wFairmanOlin/kicad_parts/README.md

Just a collection of parts and footprints I've used in projects. There is no guarantee that any of these files are accurate.
