wFairmanOlin/kicad_parts/3D_parts/BK-18650-PC2.step

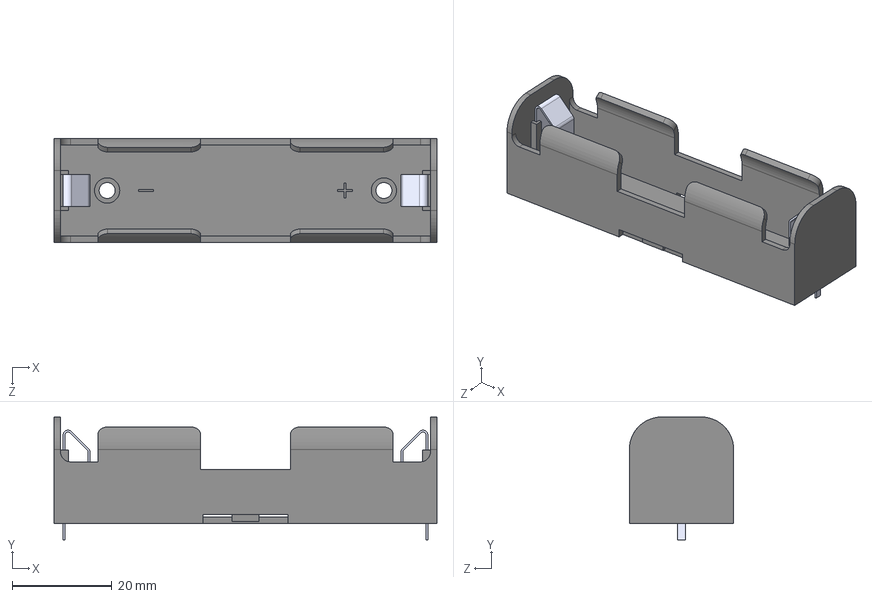
[picture p1: CAD file, 2022-10-13]
3D_parts/BK-18650-PC2.step
77.0 x 24.7 x 21.0 mm
