wFairmanOlin/kicad_parts/3D_parts/DRL0008A.stp

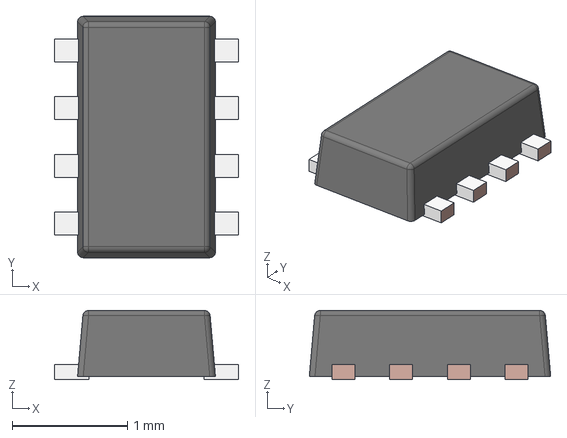
[picture p2: CAD file, 2022-10-13]
3D_parts/DRL0008A.stp
1.60 x 2.10 x 0.6 mm
FRAME-DRL0008A
BODY-SOT
