wFairmanOlin/kicad_parts/3D_parts/Female Pin Header 01x05 Pitch 2.54mm Height 8.5mm.stp

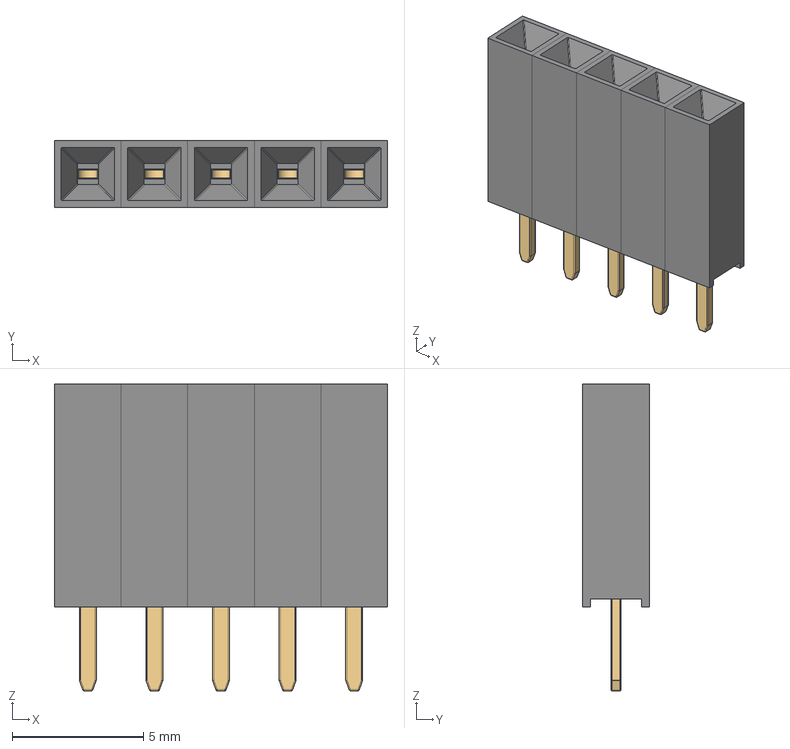
[picture p3: CAD file, 2022-10-13]
3D_parts/Female Pin Header 01x05 Pitch 2.54mm Height 8.5mm.stp
12.7 x 2.54 x 11.7 mm
Female Pin Header 1x x 5
