wFairmanOlin/kicad_parts/3D_parts/Seeeduino Xiao.step

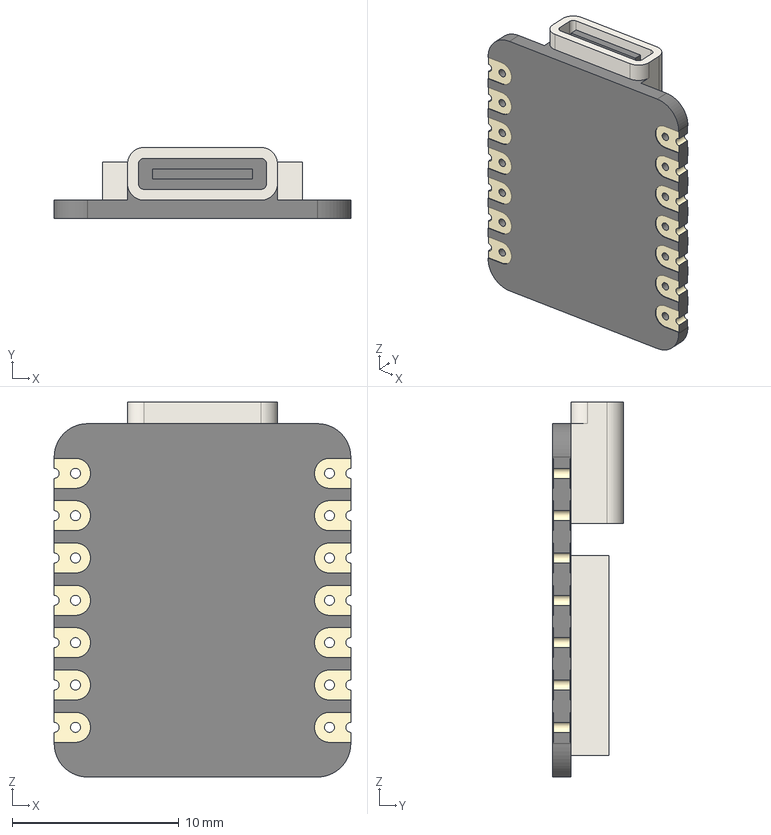
[picture p4: CAD file, 2022-10-13]
3D_parts/Seeeduino Xiao.step
17.8 x 4.27 x 22.5 mm
