wFairmanOlin/kicad_parts/3D_parts/LPS28DFWTR v1.step

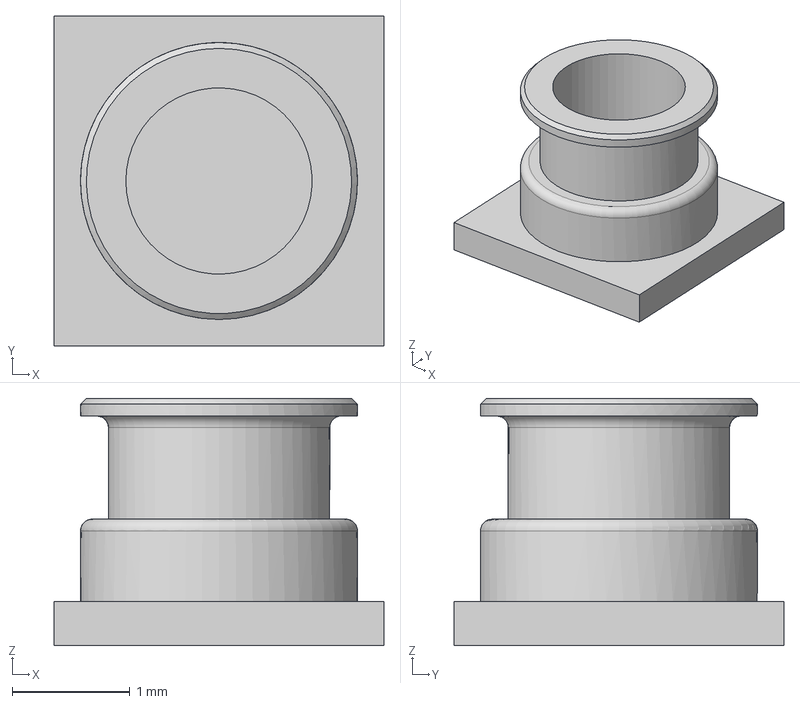
[picture p5: CAD file, 2022-10-13]
3D_parts/LPS28DFWTR v1.step
2.80 x 2.80 x 2.10 mm
