wFairmanOlin/kicad_parts/3D_parts/FTSH-105-XX-X-DV.step

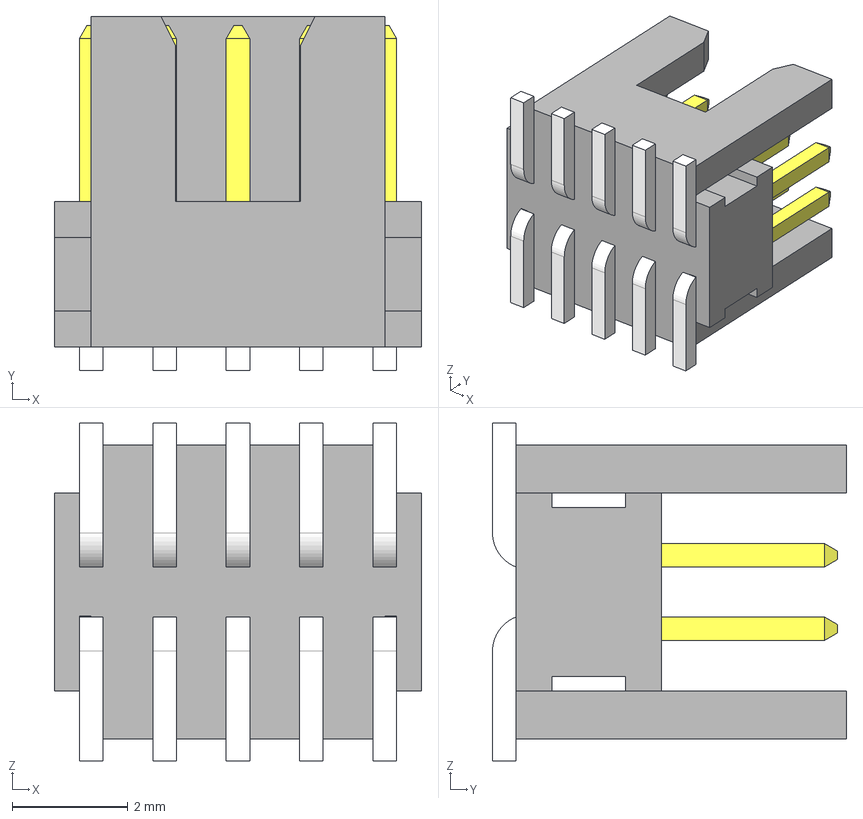
[picture p6: CAD file, 2022-10-13]
3D_parts/FTSH-105-XX-X-DV.step
6.35 x 6.12 x 5.84 mm
FTSH-105-01-L-DV-K_pins2
FTSH-105-01-L-DV-K_pins1
FTSH-105-01-L-DV-K_body
