wFairmanOlin/kicad_parts/3D_parts/PH1RB-05-UA.STEP

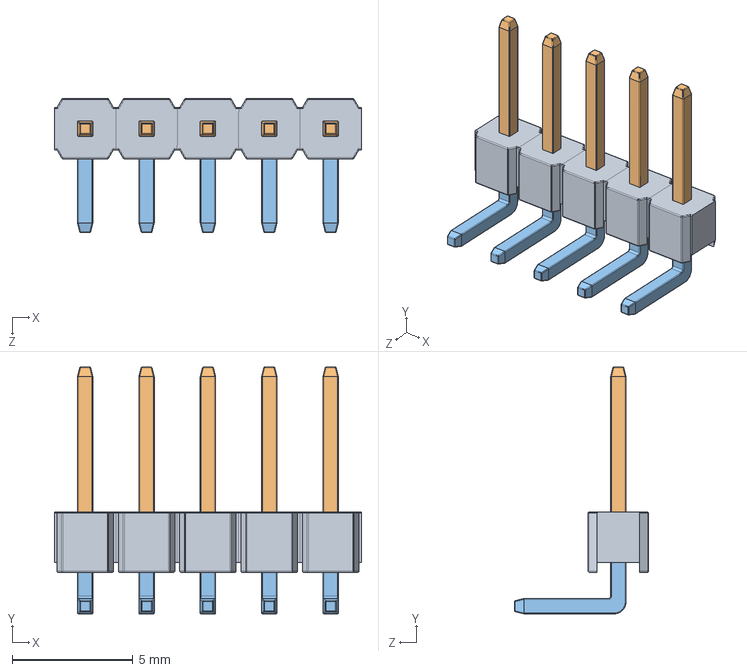
[picture p7: CAD file, 2022-10-13]
3D_parts/PH1RB-05-UA.STEP
12.7 x 10.2 x 5.55 mm
