wFairmanOlin/kicad_parts/3D_parts/SOP4pin.step

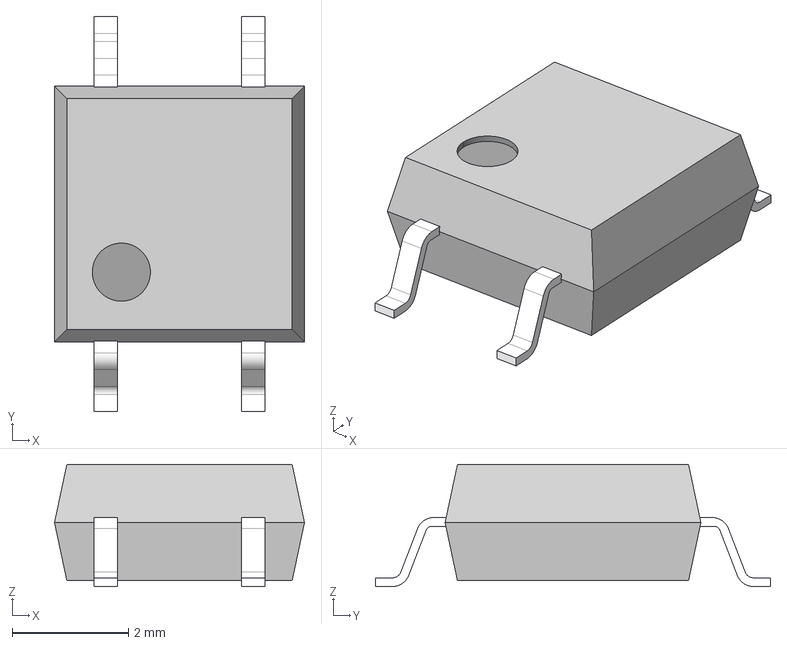
[picture p8: CAD file, 2021-06-22]
3D_parts/SOP4pin.step
4.30 x 6.80 x 2.10 mm
