wFairmanOlin/kicad_parts/3D_parts/SOIC-8_3.9x4.9mm_P1.27mm.step

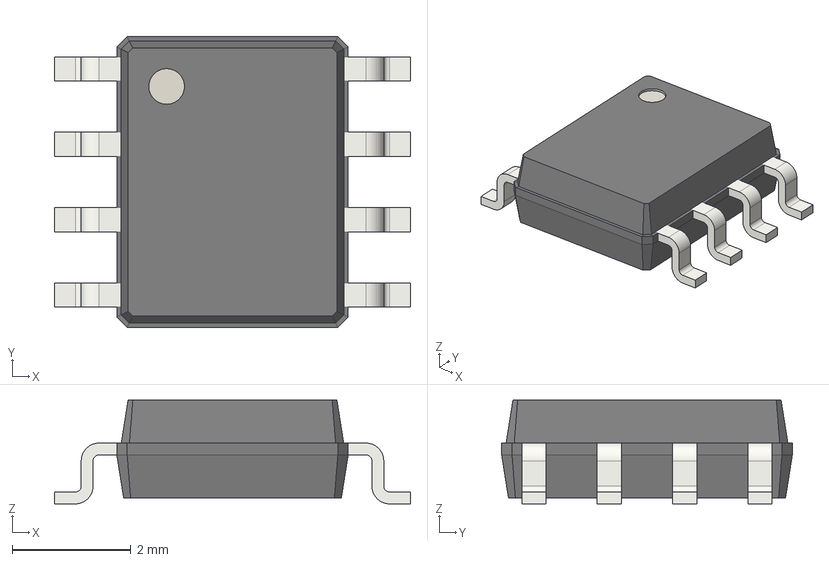
[picture p9: CAD file, 2021-03-07]
3D_parts/SOIC-8_3.9x4.9mm_P1.27mm.step
6.00 x 4.90 x 1.75 mm
