wFairmanOlin/kicad_parts/3D_parts/TSW-103-07-G-D_SAI.step

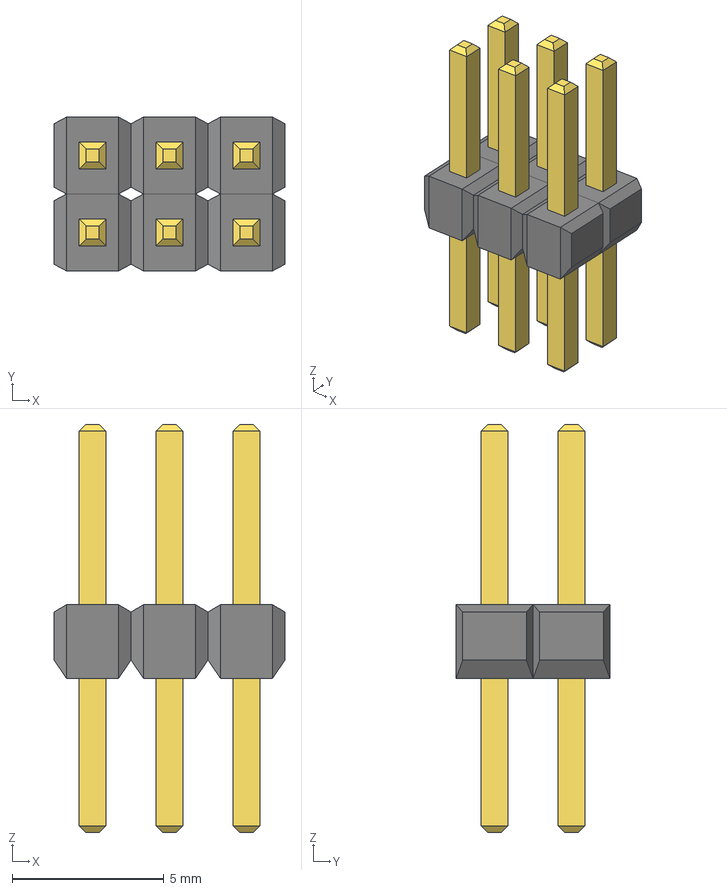
[picture p10: CAD file, 2021-03-07]
3D_parts/TSW-103-07-G-D_SAI.step
7.62 x 5.08 x 13.5 mm
