wFairmanOlin/kicad_parts/3D_parts/BMI088--3DModel-STEP-56544.STEP

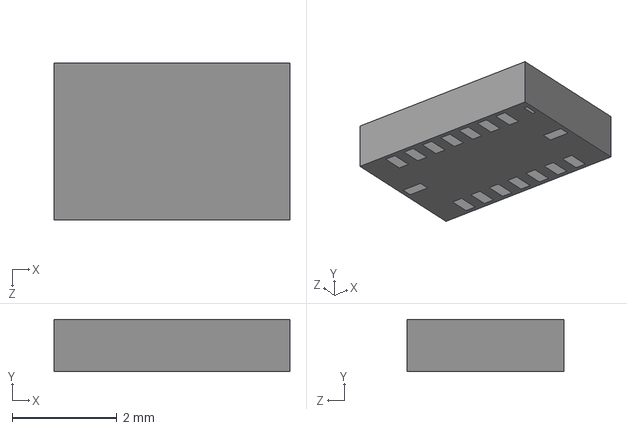
[picture p11: CAD file, 2021-03-07]
3D_parts/BMI088--3DModel-STEP-56544.STEP
4.50 x 1.00 x 3.00 mm
