wFairmanOlin/kicad_parts/3D_parts/SOT1061.step

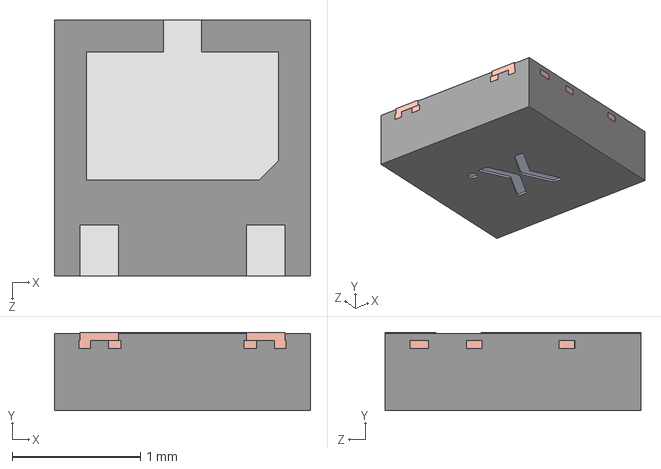
[picture p12: CAD file, 2021-03-07]
3D_parts/SOT1061.step
2.00 x 0.61 x 2.00 mm
SOT1061A LF
SOT1061 Mold body
