wFairmanOlin/kicad_parts/3D_parts/USB_Micro-B_Molex_47346-0001.step

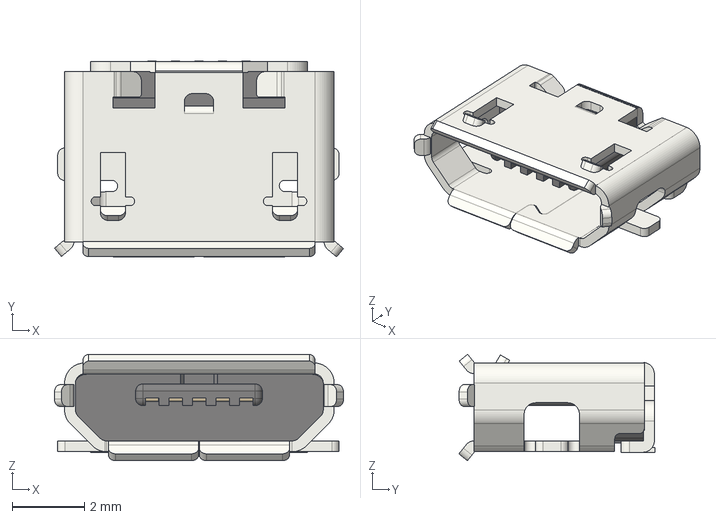
[picture p13: CAD file, 2021-03-07]
3D_parts/USB_Micro-B_Molex_47346-0001.step
7.98 x 5.42 x 2.94 mm
