wFairmanOlin/kicad_parts/3D_parts/LQFP-64_10x10mm_P0.5mm.step

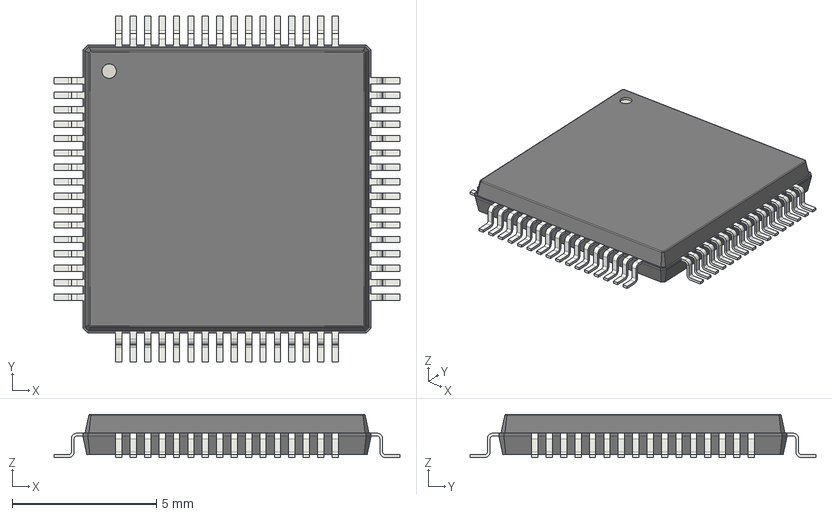
[picture p14: CAD file, 2021-03-07]
3D_parts/LQFP-64_10x10mm_P0.5mm.step
12.0 x 12.0 x 1.50 mm
