wFairmanOlin/kicad_parts/3D_parts/LED_0805_2012Metric.step

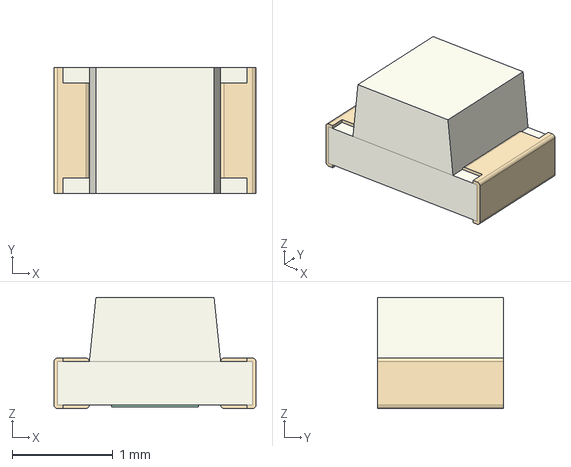
[picture p15: CAD file, 2021-03-07]
3D_parts/LED_0805_2012Metric.step
2.00 x 1.25 x 1.10 mm
