wFairmanOlin/kicad_parts/3D_parts/D_SOD-323F.step

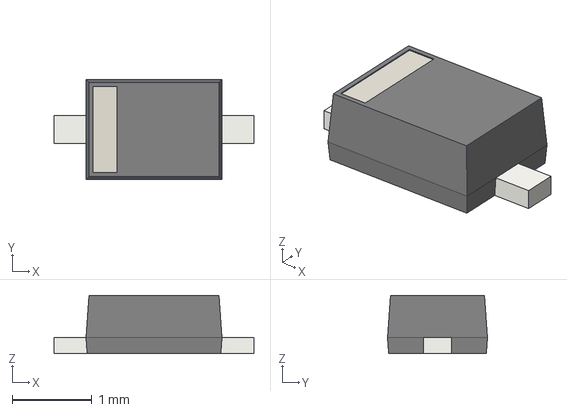
[picture p16: CAD file, 2021-03-07]
3D_parts/D_SOD-323F.step
2.50 x 1.25 x 0.73 mm
