wFairmanOlin/kicad_parts/3D_parts/LIS3MDLTR--3DModel-STEP-56544.STEP

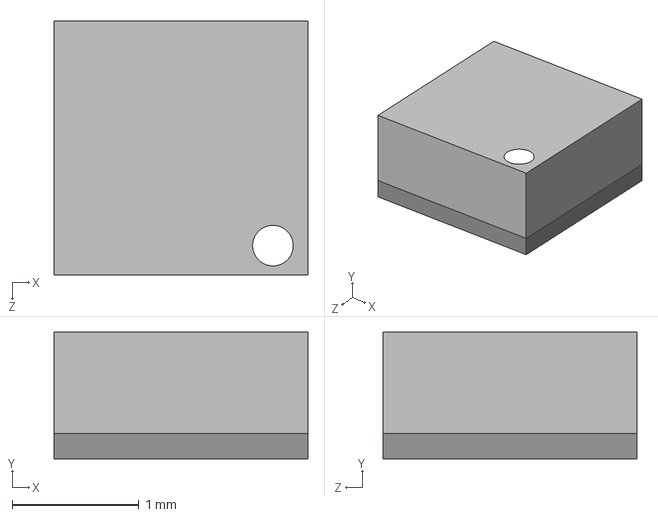
[picture p17: CAD file, 2021-03-07]
3D_parts/LIS3MDLTR--3DModel-STEP-56544.STEP
2.00 x 1.00 x 2.00 mm
