wFairmanOlin/kicad_parts/3D_parts/SOT-23.step

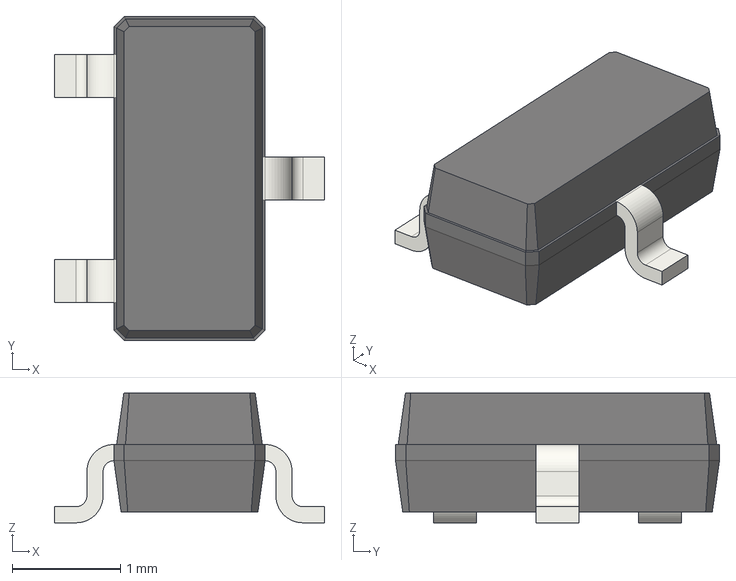
[picture p18: CAD file, 2021-03-07]
3D_parts/SOT-23.step
2.50 x 3.00 x 1.20 mm
