wFairmanOlin/kicad_parts/3D_parts/SOT25_DIO.step

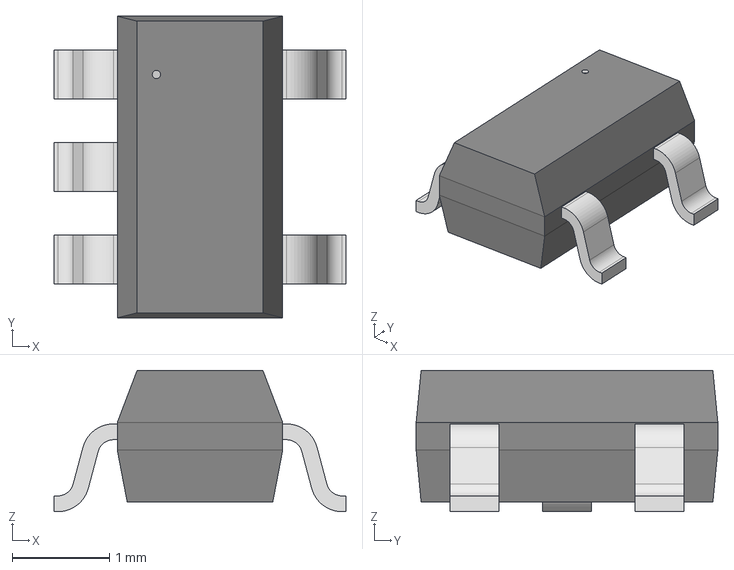
[picture p19: CAD file, 2021-03-07]
3D_parts/SOT25_DIO.step
3.00 x 3.10 x 1.45 mm
