wFairmanOlin/kicad_parts/3D_parts/mps_dcdc_okl_t1_a.step

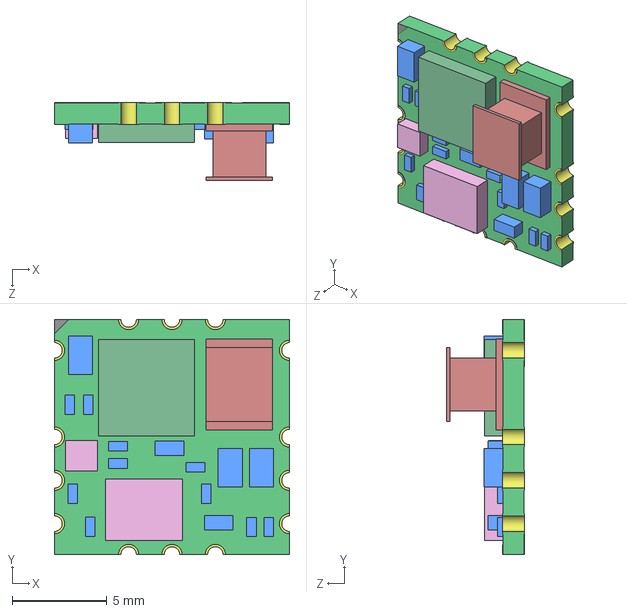
[picture p20: CAD file, 2021-03-07]
3D_parts/mps_dcdc_okl_t1_a.step
12.4 x 12.4 x 4.12 mm
