wFairmanOlin/kicad_parts/3D_parts/c-ms560702ba03-50-a-3d.stp

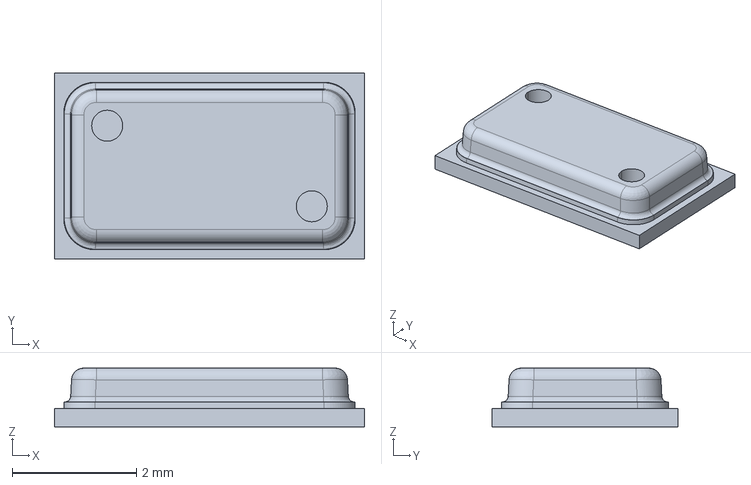
[picture p21: CAD file, 2021-03-07]
3D_parts/c-ms560702ba03-50-a-3d.stp
5.00 x 3.00 x 0.95 mm
