wFairmanOlin/kicad_parts/3D_parts/C_0402_1005Metric.step

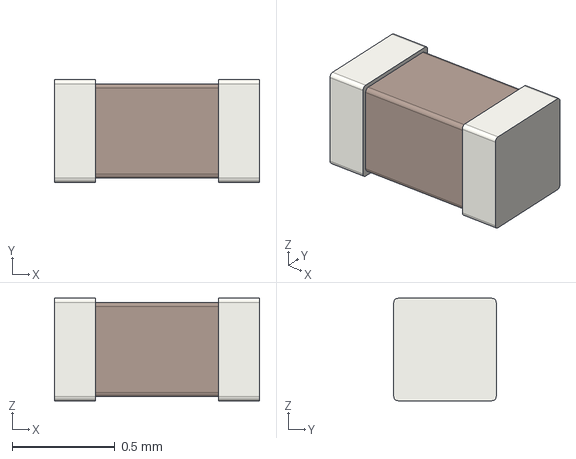
[picture p22: CAD file, 2021-03-07]
3D_parts/C_0402_1005Metric.step
1.00 x 0.5 x 0.5 mm
