wFairmanOlin/kicad_parts/3D_parts/STM32F427VIT6.STEP

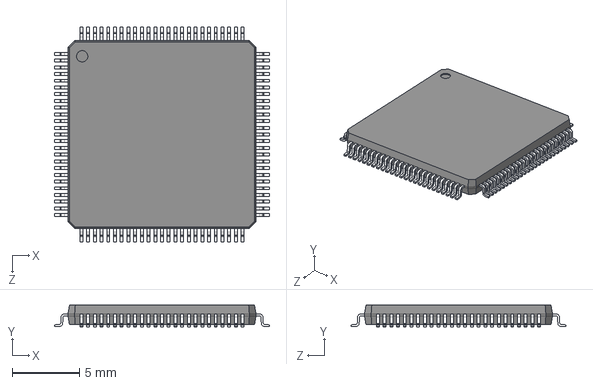
[picture p23: CAD file, 2020-12-12]
3D_parts/STM32F427VIT6.STEP
16.0 x 1.60 x 16.0 mm
