wFairmanOlin/kicad_parts/3D_parts/CON2_1X2_TU_TSW.step

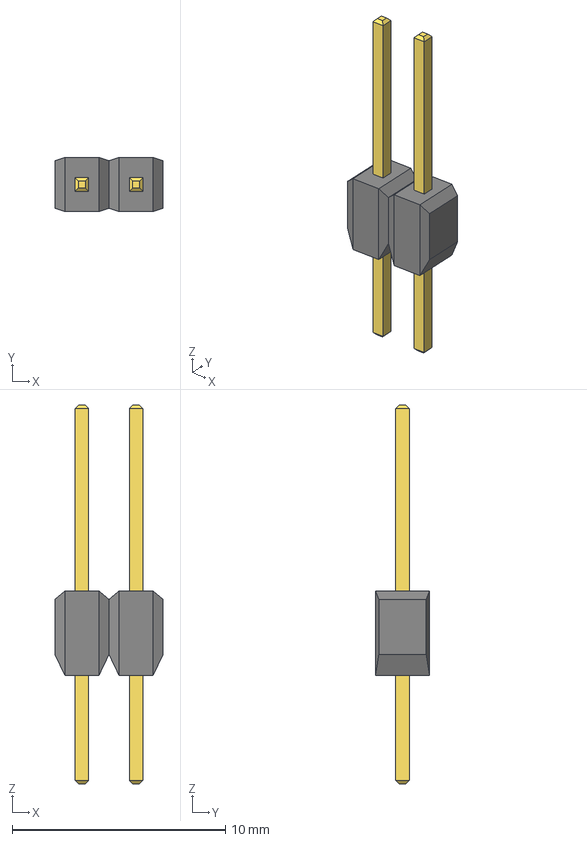
[picture p24: CAD file, 2020-12-12]
3D_parts/CON2_1X2_TU_TSW.step
5.08 x 2.54 x 17.8 mm
