wFairmanOlin/kicad_parts/3D_parts/CAM-M8Q-0--3DModel-STEP-56544.STEP

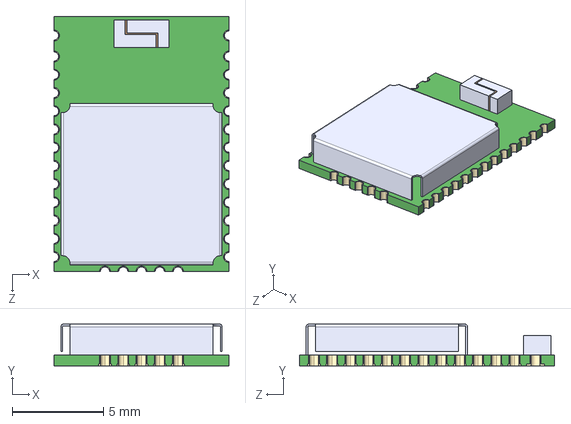
[picture p25: CAD file, 2020-12-12]
3D_parts/CAM-M8Q-0--3DModel-STEP-56544.STEP
9.60 x 2.30 x 14.0 mm
