wFairmanOlin/kicad_parts/3D_parts/rsmd-0805_l2_w1-25_h0-6.stp

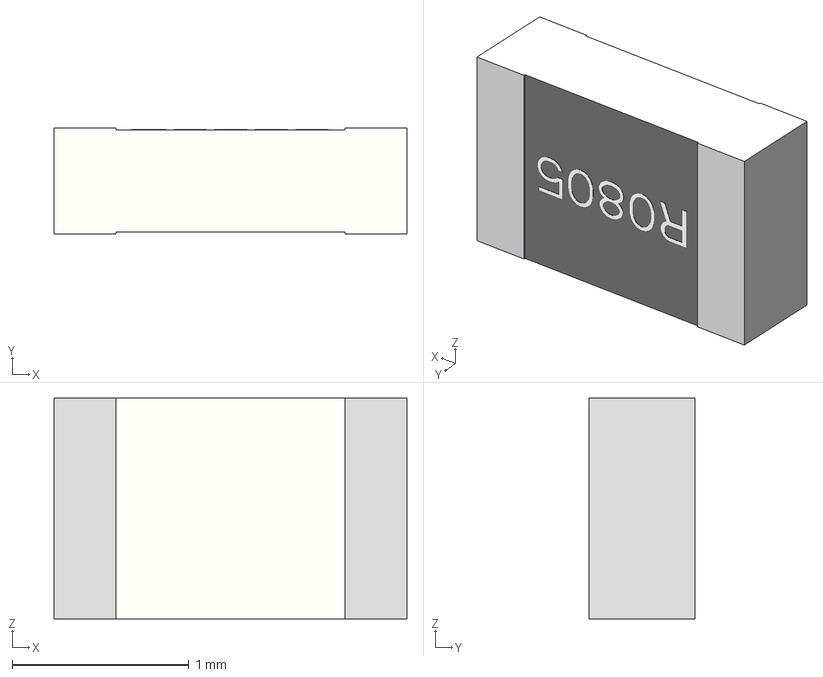
[picture p26: CAD file, 2020-12-12]
3D_parts/rsmd-0805_l2_w1-25_h0-6.stp
2.00 x 0.6 x 1.25 mm
