wFairmanOlin/kicad_parts/3D_parts/CAP_J-V_6P3X6P1_RUB.step

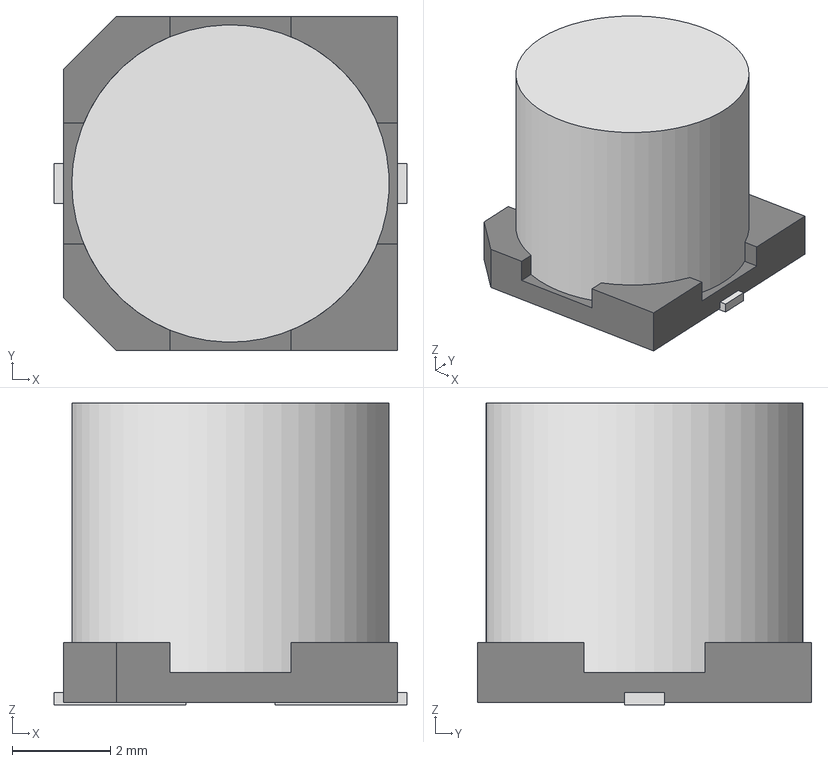
[picture p27: CAD file, 2020-12-12]
3D_parts/CAP_J-V_6P3X6P1_RUB.step
7.19 x 6.81 x 6.15 mm
