wFairmanOlin/kicad_parts/3D_parts/NX3225SA-24_000M-STD-CSR-1_NDK.step

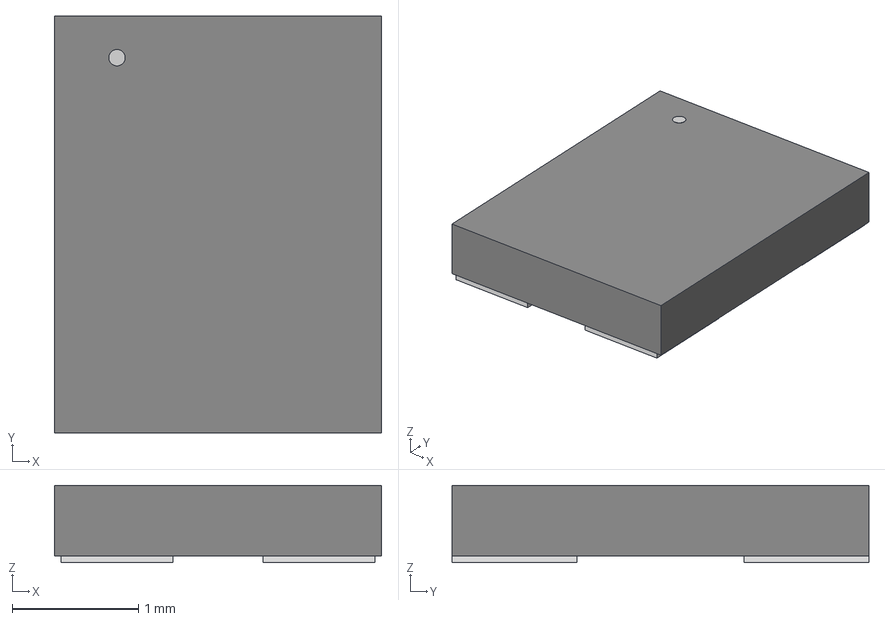
[picture p28: CAD file, 2020-12-12]
3D_parts/NX3225SA-24_000M-STD-CSR-1_NDK.step
2.59 x 3.30 x 0.612 mm
