wFairmanOlin/kicad_parts/3D_parts/SM06B-GHS-TB(LF)(SN)--3DModel-STEP-56544.STEP

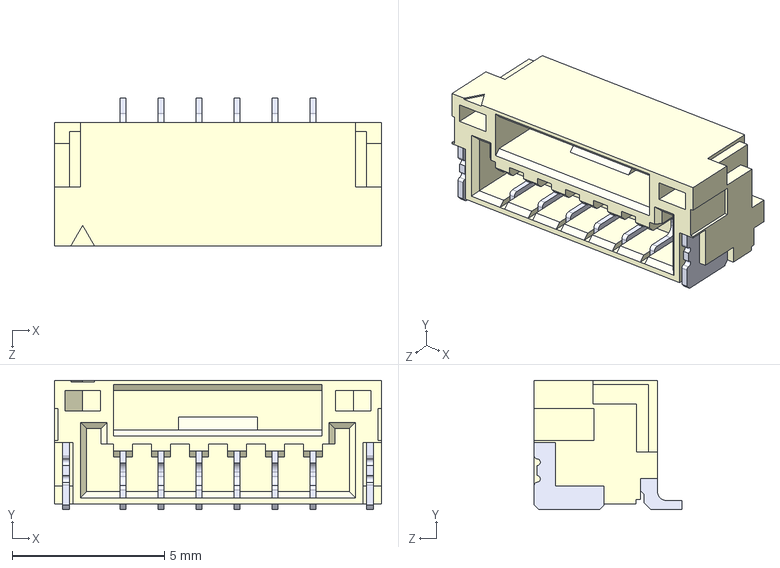
[picture p30: CAD file, 2020-12-12]
3D_parts/SM06B-GHS-TB(LF)(SN)--3DModel-STEP-56544.STEP
10.8 x 4.25 x 4.85 mm
