wFairmanOlin/kicad_parts/3D_parts/csmd-0805_l2-01_w1-25_h1-27.stp

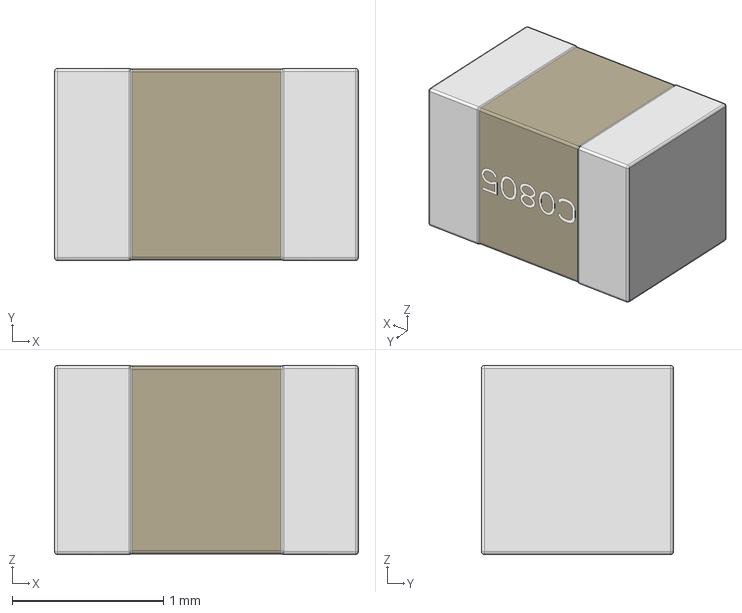
[picture p31: CAD file, 2020-12-12]
3D_parts/csmd-0805_l2-01_w1-25_h1-27.stp
2.01 x 1.27 x 1.25 mm
