wFairmanOlin/kicad_parts/3D_parts/SM04B-GHS-TB(LF)(SN)---3DModel-STEP-56544.STEP

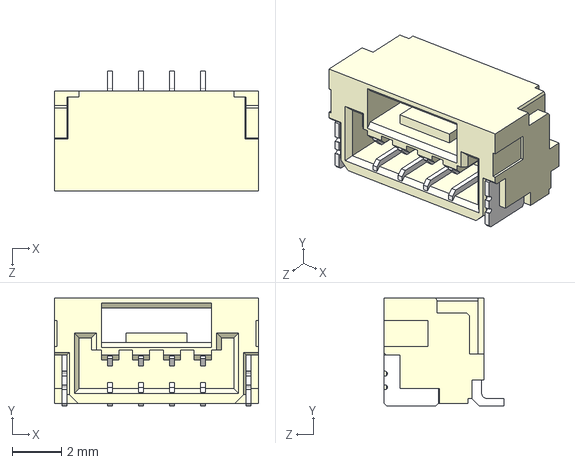
[picture p32: CAD file, 2020-12-12]
3D_parts/SM04B-GHS-TB(LF)(SN)---3DModel-STEP-56544.STEP
8.25 x 4.35 x 4.85 mm
