wFairmanOlin/kicad_parts/3D_parts/SM08B-SRSS-TB(LF)(SN)--3DModel-STEP-56544.STEP

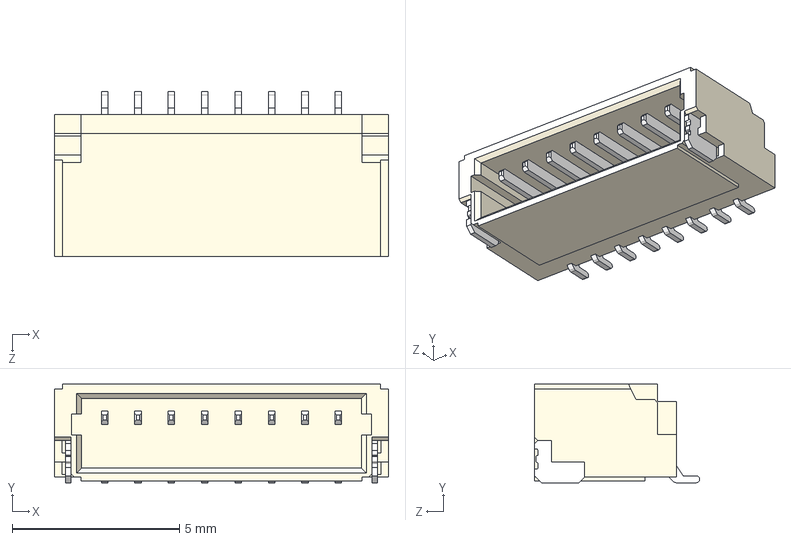
[picture p33: CAD file, 2020-12-12]
3D_parts/SM08B-SRSS-TB(LF)(SN)--3DModel-STEP-56544.STEP
10.00 x 2.95 x 4.95 mm
