wFairmanOlin/kicad_parts/3D_parts/CAP_UCD_6P3X5P8_NCH.step

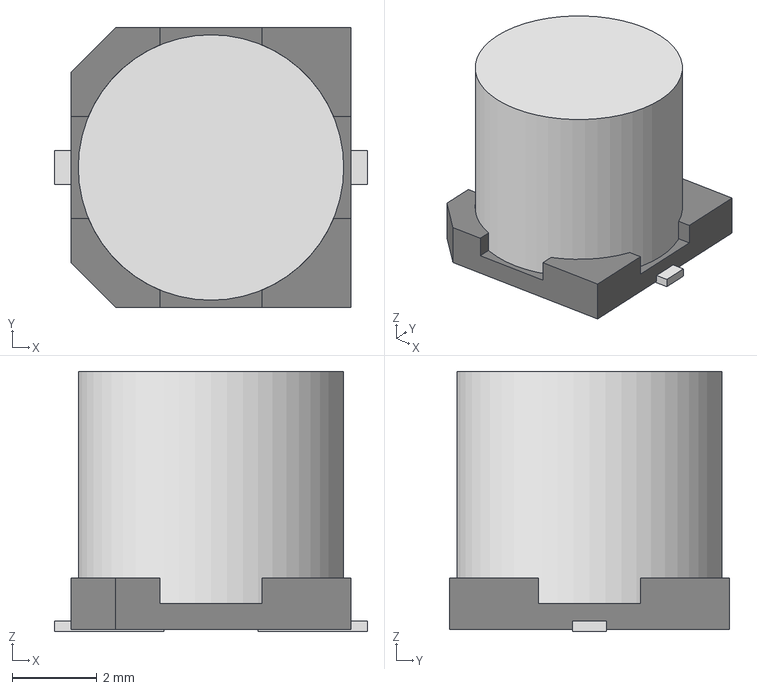
[picture p34: CAD file, 2020-12-12]
3D_parts/CAP_UCD_6P3X5P8_NCH.step
7.39 x 6.60 x 6.15 mm
