wFairmanOlin/kicad_parts/(list of files, cad)

Other CAD files:
3D_parts/1051620001--3DModel-STEP-56544.STEP
3D_parts/1051620001.stp
3D_parts/1989748.stp
3D_parts/473460001.stp
3D_parts/744066005_Download_STP_WE-TPC-1038_rev1.stp
3D_parts/screw_conn_ostte020161.step
