wFairmanOlin/kicad_parts/(commit log)

2020-12-12 added initial parts
    [473460001.stp, 744066005_Download_STP_WE-TPC-1038_rev1.stp, CAM-M8Q-0--3DModel-STEP-56544.STEP, CAP_J-V_6P3X6P1_RUB.step, CAP_UCD_6P3X5P8_NCH.step, CON2_1X2_TU_TSW.step, NX3225SA-24_000M-STD-CSR-1_NDK.step, SM04B-GHS-TB(LF)(SN)---3DModel-STEP-56544.STEP]
2021-01-23 added buck converter
2021-01-25 added new buck converter and fixed .dcm, .bck files
2021-02-21 added more components
    [1051620001--3DModel-STEP-56544.STEP]
2021-03-07 added more parts and 3d models
    [1051620001.stp, BMI088--3DModel-STEP-56544.STEP, C_0402_1005Metric.step, D_SOD-323F.step, LED_0805_2012Metric.step, LIS3MDLTR--3DModel-STEP-56544.STEP, LQFP-64_10x10mm_P0.5mm.step, SOIC-8_3.9x4.9mm_P1.27mm.step]
2021-06-22 added new components
    [SOP4pin.step]
2022-10-13 added additional parts for HAUCS proj
    [1989748.stp, BK-18650-PC2.step, DRL0008A.stp, FTSH-105-XX-X-DV.step, Female Pin Header 01x05 Pitch 2.54mm Height 8.5mm.stp, LPS28DFWTR v1.step, PH1RB-05-UA.STEP, Seeeduino Xiao.step]
