wFairmanOlin/kicad_parts/(notices)

Notices in the files:
3D_parts/LQFP-64_10x10mm_P0.5mm.step:
Copyright (C) 2017, kicad StepUp
This work is licensed under the [Creative Commons CC-BY-SA 4.0 License](https://creativecommons.org/licenses/by-sa/4.0/legalcode),
with the following exception:
To the extent that the creation of electronic designs that use 'Licensed Material' can be considered to be 'Adapted Material',
You are free to use the library data in your own projects without the obligation to share your project files under this or any other license agreement.
3D_parts/D_SOD-323F.step:
This program is free software: you can redistribute it and/or modify
it under the terms of the GNU General Public License as published by
the Free Software Foundation, either version 3 of the License, or
any later version.
itself might be covered by the GNU General Public License.
3D_parts/LED_0805_2012Metric.step:
Copyright (C) 2018, kicad StepUp
3D_parts/FTSH-105-XX-X-DV.step:
author */ ('License CC BY-ND 4.0'),
